Diocta/ISYARA/docs/3d_design/preview_3d_interactive.html

# 📐 ISYARA V2 3D Viewer

Preview langsung file STL cadangan untuk casing perangkat ISYARA (AITC UNAIR 2026).

Assembled Enclosure (Utuh)

💡 Navigasi 3D:

• Klik Kiri + Geser: Putar 360°

• Scroll Mouse: Zoom In / Out

• Klik Kanan + Geser: Panning (Geser Posisi)

Dimensi: 76 × 150 × 22.4 mm
Watertight: Ya (100% Manifold)

📦 Casing Utuh (Assembled) 📱 Sisi User (Back Shell) 📷 Sisi Depan (Front Shell) 🕸️ Wireframe 🔄 Auto Putar
