Diocta/ISYARA/docs/3d_design/preview_back_shell.png

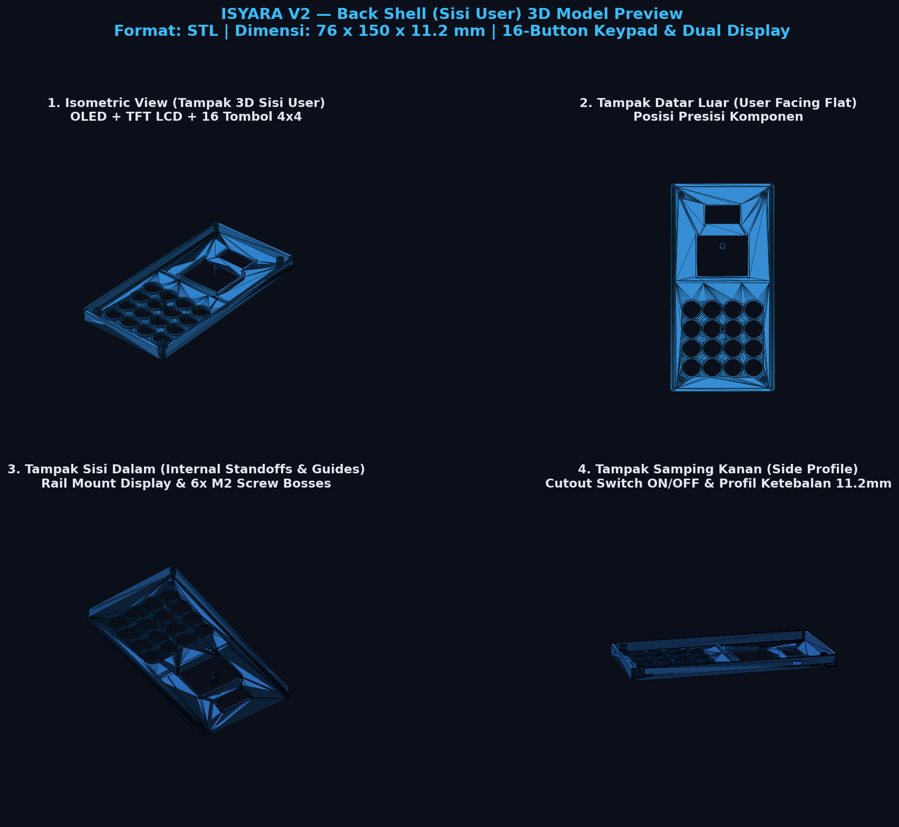
docs/3d_design/preview_back_shell.png
