Diocta/ISYARA/docs/presentation/poster_lipat_dalam.png

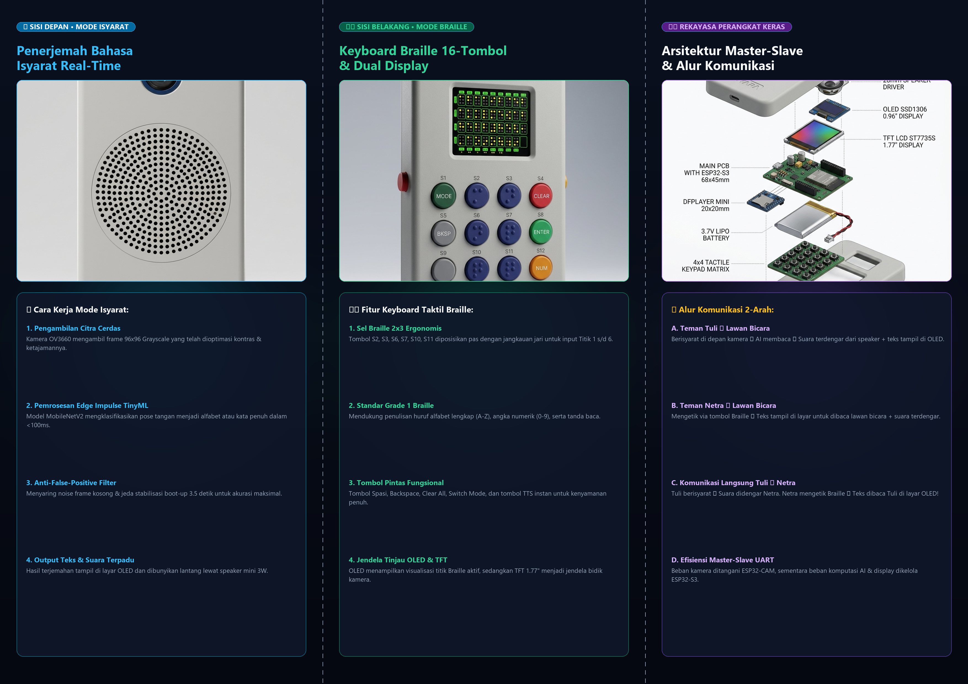
docs/presentation/poster_lipat_dalam.png
