Diocta/ISYARA/docs/presentation/poster_lipat_luar.png

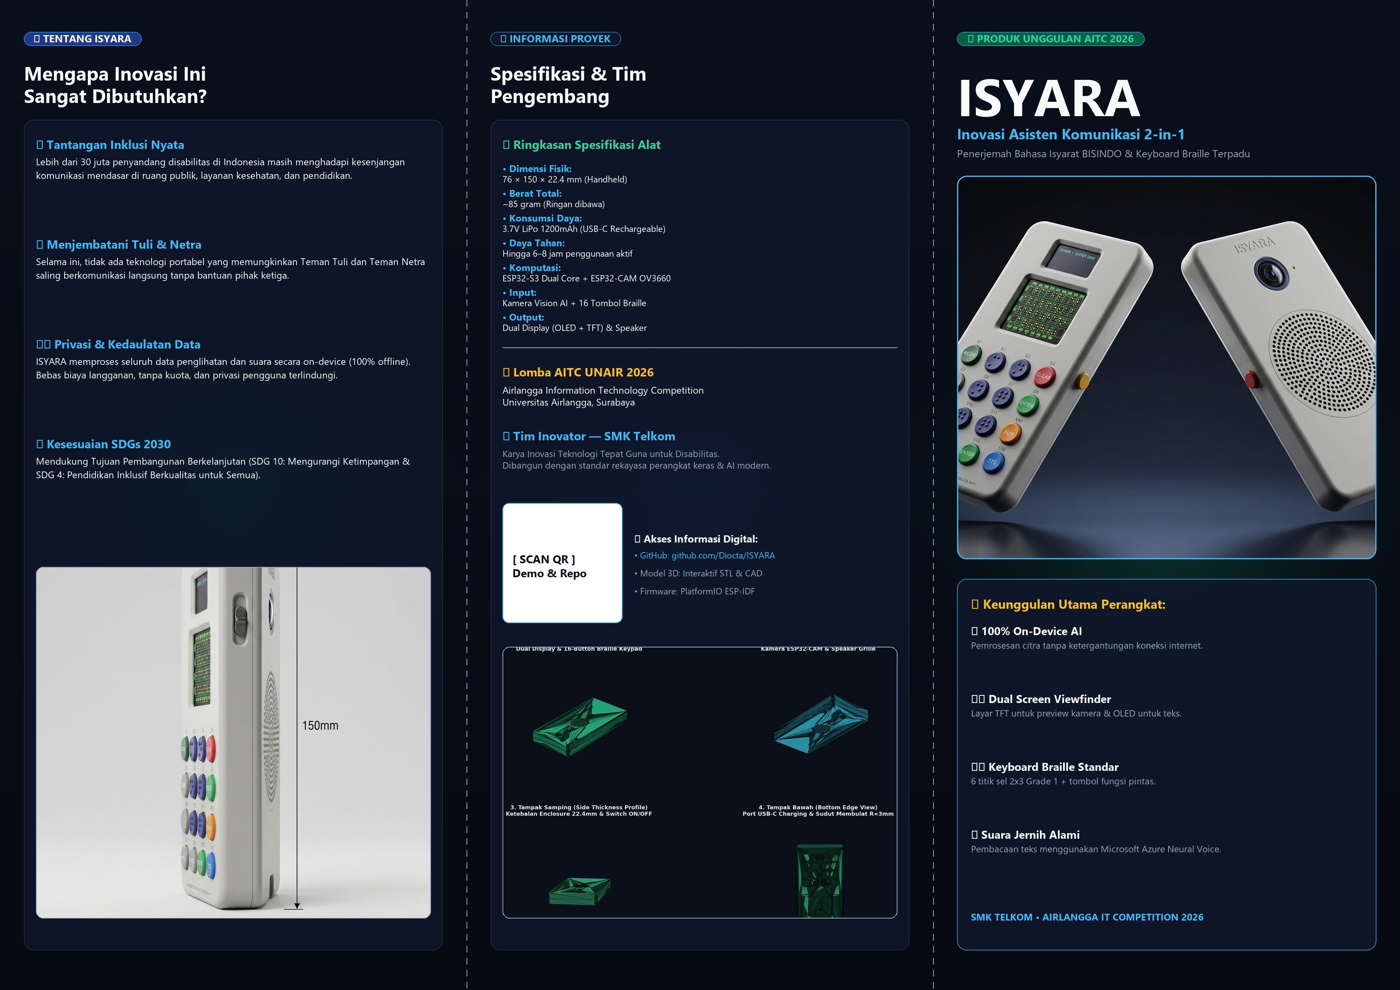
docs/presentation/poster_lipat_luar.png
