Diocta/ISYARA/docs/preview_idle_bw_samples.png

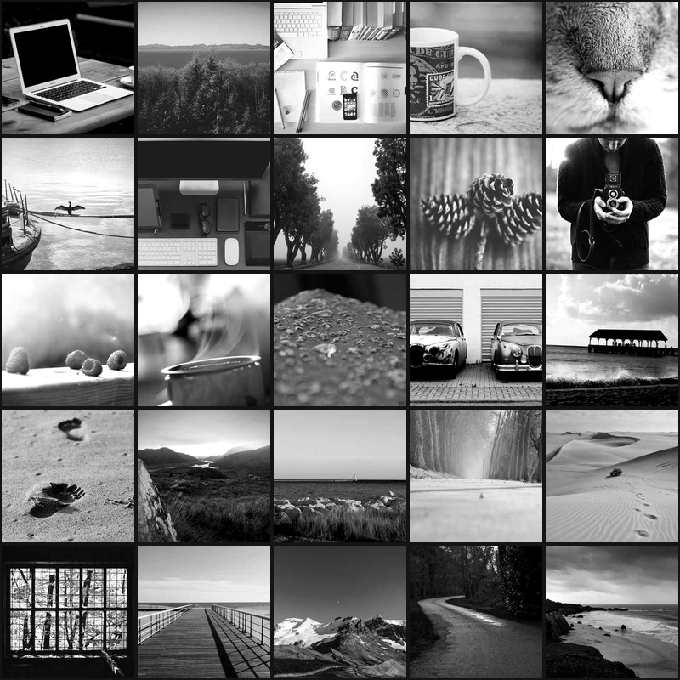
docs/preview_idle_bw_samples.png
