Diocta/ISYARA/docs/3d_design/isyara_assembled_enclosure.stl

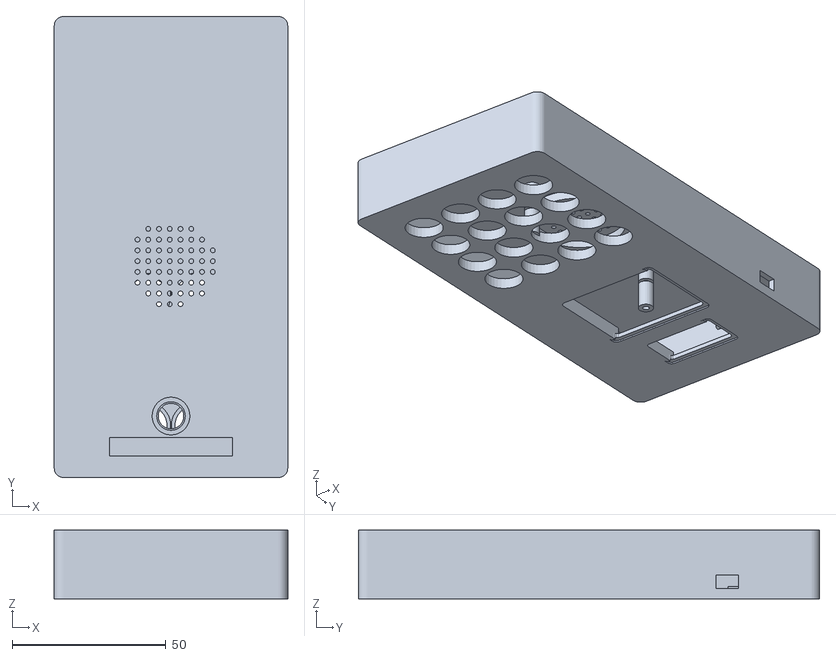
[picture p5: CAD file, 2026-10-30]
docs/3d_design/isyara_assembled_enclosure.stl
76.0 x 150.0 x 22.4
