Diocta/ISYARA/docs/3d_design/isyara_braille_button_cap.stl

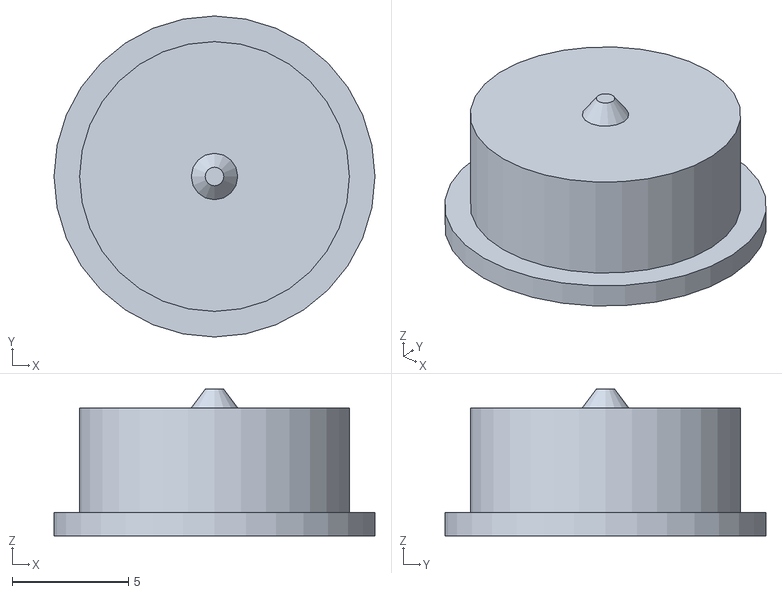
[picture p6: CAD file, 2026-10-30]
docs/3d_design/isyara_braille_button_cap.stl
13.8 x 13.8 x 6.30
