Diocta/ISYARA/docs/3d_design/isyara_back_shell.stl

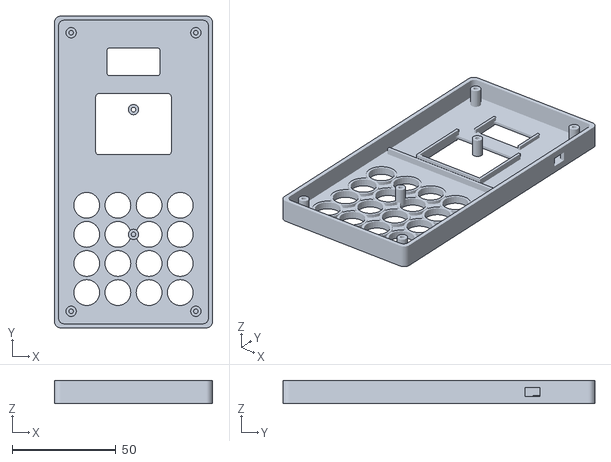
[picture p7: CAD file, 2026-10-30]
docs/3d_design/isyara_back_shell.stl
76.0 x 150.0 x 11.2
