Diocta/ISYARA/(list of files, cad)

Other CAD files:
docs/3d_design/isyara_assembled_enclosure.obj
docs/3d_design/isyara_back_shell.obj
docs/3d_design/isyara_braille_button_cap.obj
docs/3d_design/isyara_front_shell.obj
