Diocta/ISYARA/docs/3d_design/preview_assembled_enclosure.png

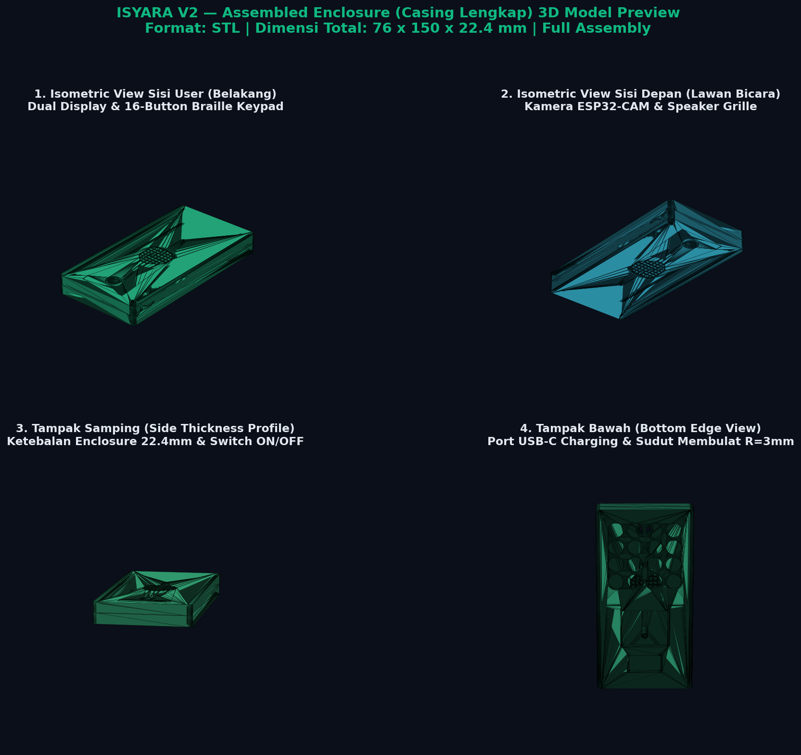
docs/3d_design/preview_assembled_enclosure.png
