Diocta/ISYARA/src/s3/braille_keypad.h

#ifndef BRAILLE_KEYPAD_H
#define BRAILLE_KEYPAD_H

#include <Arduino.h>
#include <Adafruit_GFX.h>
#include <Adafruit_SSD1306.h>
#include <Adafruit_ST7735.h>
#include "audio_manager.h"

// Deklarasi maju softap_add_event (didefinisikan di softap_server.h)
// Stubs akan aktif jika ENABLE_SOFTAP tidak didefinisikan
#ifndef ENABLE_SOFTAP
  inline void softap_add_event(const char*, const char*) {}
#else
  void softap_add_event(const char* source, const char* message);
#endif

// =============================================================================
// ISYARA - Modul Keyboard Braille 4x4 Tactile Matrix (ESP32-S3)
// =============================================================================
// Pemetaan Pinout Modul 4x4 Tactile (Option A Breakout PCB):
// Pin 1 (Top)    = Col 4 -> GPIO 4
// Pin 2          = Col 3 -> GPIO 5
// Pin 3          = Col 2 -> GPIO 6
// Pin 4          = Col 1 -> GPIO 7
// Pin 5          = Row 1 -> GPIO 13
// Pin 6          = Row 2 -> GPIO 16
// Pin 7          = Row 3 -> GPIO 21
// Pin 8 (Bottom) = Row 4 -> GPIO 47
// =============================================================================

// Baris (Rows): Pin 5, 6, 7, 8 pada modul (INPUT_PULLUP)
// Pin 5 = Row 1 -> GPIO 13 (S1, S2, S3, S4)
// Pin 6 = Row 2 -> GPIO 16 (S5, S6, S7, S8)
// Pin 8 = Row 3 -> GPIO 47 (S9, S10, S11, S12)
// Pin 7 = Row 4 -> GPIO 21 (S13, S14, S15, S16)
#define KEYPAD_R1 13
#define KEYPAD_R2 16
#define KEYPAD_R3 47
#define KEYPAD_R4 21

// Kolom (Cols): Pin 4, 3, 2, 1 pada modul (OUTPUT LOW saat di-scan)
// Pin 4 = Col 1 -> GPIO 7  (S1, S5, S9, S13)
// Pin 3 = Col 2 -> GPIO 6  (S2, S6, S10, S14)
// Pin 2 = Col 3 -> GPIO 5  (S3, S7, S11, S15)
// Pin 1 = Col 4 -> GPIO 4  (S4, S8, S12, S16)
#define KEYPAD_C1 7
#define KEYPAD_C2 6
#define KEYPAD_C3 5
#define KEYPAD_C4 4

const uint8_t ROW_PINS[4] = {KEYPAD_R1, KEYPAD_R2, KEYPAD_R3, KEYPAD_R4};
const uint8_t COL_PINS[4] = {KEYPAD_C1, KEYPAD_C2, KEYPAD_C3, KEYPAD_C4};

// Indeks ID Tombol S1 - S16 Sesuai Silkscreen PCB Fisik:
// S1  = (R1, C1) | S2  = (R1, C2) | S3  = (R1, C3) | S4  = (R1, C4)
// S5  = (R2, C1) | S6  = (R2, C2) | S7  = (R2, C3) | S8  = (R2, C4)
// S9  = (R3, C1) | S10 = (R3, C2) | S11 = (R3, C3) | S12 = (R3, C4)
// S13 = (R4, C1) | S14 = (R4, C2) | S15 = (R4, C3) | S16 = (R4, C4)

// State Tombol Matriks (Debounce Independen per Tombol)
static bool key_state[4][4] = {false};
static unsigned long key_debounce_time[4][4] = {0};
const unsigned long DEBOUNCE_MS = 35;

// Indikator Tombol Terakhir untuk Feedback Visual OLED & TFT
static char last_key_badge[16] = "";
static unsigned long last_key_badge_time = 0;
const unsigned long BADGE_DURATION_MS = 1800;

// Buffer Titik Braille (6-dot cell)
// Bit 0: Titik 1 (S2)  | Bit 3: Titik 4 (S3)
// Bit 1: Titik 2 (S6)  | Bit 4: Titik 5 (S7)
// Bit 2: Titik 3 (S10) | Bit 5: Titik 6 (S11)
static uint8_t braille_dots = 0;
static bool number_mode = false;
static unsigned long last_dot_time = 0;
const unsigned long AUTO_COMMIT_MS = 2500; // Nyaman: 2.5 detik untuk mengecek preview titik

// Mode Sistem
enum DeviceMode {
  MODE_AI_BISINDO = 0,
  MODE_BRAILLE = 1
};
extern DeviceMode current_device_mode;
extern String kalimat;
extern bool tft_butuh_update_mode;
extern void perbarui_oled_seketika();

// Fungsi Dekoder Braille (Mask 6-bit -> Karakter ASCII)
char decode_braille_to_char(uint8_t mask, bool is_num) {
  if (mask == 0) return '\0';

  char ch = '\0';
  switch (mask) {
    case 0b000001: ch = 'A'; break; // Titik 1
    case 0b000011: ch = 'B'; break; // Titik 1, 2
    case 0b001001: ch = 'C'; break; // Titik 1, 4
    case 0b011001: ch = 'D'; break; // Titik 1, 4, 5
    case 0b010001: ch = 'E'; break; // Titik 1, 5
    case 0b001011: ch = 'F'; break; // Titik 1, 2, 4
    case 0b011011: ch = 'G'; break; // Titik 1, 2, 4, 5
    case 0b010011: ch = 'H'; break; // Titik 1, 2, 5
    case 0b001010: ch = 'I'; break; // Titik 2, 4
    case 0b011010: ch = 'J'; break; // Titik 2, 4, 5
    case 0b000101: ch = 'K'; break; // Titik 1, 3
    case 0b000111: ch = 'L'; break; // Titik 1, 2, 3
    case 0b001101: ch = 'M'; break; // Titik 1, 3, 4
    case 0b011101: ch = 'N'; break; // Titik 1, 3, 4, 5
    case 0b010101: ch = 'O'; break; // Titik 1, 3, 5
    case 0b001111: ch = 'P'; break; // Titik 1, 2, 3, 4
    case 0b011111: ch = 'Q'; break; // Titik 1, 2, 3, 4, 5
    case 0b010111: ch = 'R'; break; // Titik 1, 2, 3, 5
    case 0b001110: ch = 'S'; break; // Titik 2, 3, 4
    case 0b011110: ch = 'T'; break; // Titik 2, 3, 4, 5
    case 0b100101: ch = 'U'; break; // Titik 1, 3, 6
    case 0b100111: ch = 'V'; break; // Titik 1, 2, 3, 6
    case 0b111010: ch = 'W'; break; // Titik 2, 4, 5, 6
    case 0b101101: ch = 'X'; break; // Titik 1, 3, 4, 6
    case 0b111101: ch = 'Y'; break; // Titik 1, 3, 4, 5, 6
    case 0b110101: ch = 'Z'; break; // Titik 1, 3, 5, 6
    
    // Tanda Baca
    case 0b000010: ch = ','; break;
    case 0b110010: ch = '.'; break;
    case 0b100110: ch = '?'; break;
    case 0b010110: ch = '!'; break;
    case 0b100100: ch = '-'; break;
    default: ch = '?'; break;
  }

  if (is_num && ch >= 'A' && ch <= 'J') {
    if (ch == 'J') return '0';
    return (char)('1' + (ch - 'A'));
  }

  return ch;
}

// Inisialisasi Pin Keypad 4x4
void braille_keypad_init() {
  for (int r = 0; r < 4; r++) {
    pinMode(ROW_PINS[r], INPUT_PULLUP);
  }
  for (int c = 0; c < 4; c++) {
    pinMode(COL_PINS[c], INPUT);
  }
  Serial.println("[BRAILLE] Keypad 4x4 Diinisialisasi (Rows: 13,16,47,21 | Cols: 7,6,5,4)");
  Serial.println("==================================================");
  Serial.println("  ISYARA - Layout Fisik Keyboard Braille 4x4:");
  Serial.println("  [S1:Mode]   [S2:Dot1]   [S3:Dot4]   [S4:Clear]");
  Serial.println("  [S5:Bksp]   [S6:Dot2]   [S7:Dot5]   [S8:Enter]");
  Serial.println("  [S9:Space]  [S10:Dot3]  [S11:Dot6]  [S12:Num]");
  Serial.println("  [S13:Bksp]  [S14:Space] [S15:Enter] [S16:TTS]");
  Serial.println("==================================================");
}

// Fungsi Commit Karakter Braille ke Kalimat
void commit_braille_char() {
  if (braille_dots != 0) {
    char c = decode_braille_to_char(braille_dots, number_mode);
    if (c != '\0' && c != '?') {
      kalimat += c;
      Serial.printf("[BRAILLE] Huruf Dikunci: '%c' (Mask: 0x%02X) -> Kalimat: %s\n", c, braille_dots, kalimat.c_str());
      audio.playChar(c);
      // Catat event ke SoftAP Dashboard log
      char ch_str[3] = {c, '\0', '\0'};
      softap_add_event("Keyboard Braille", ch_str);
    } else {
      Serial.printf("[BRAILLE] Pola Titik Tidak Dikenal (Mask: 0x%02X)\n", braille_dots);
    }
    braille_dots = 0;
  }
}

// Handler Aksi Setiap Tombol S1 - S16
void handle_key_action(int key_num) {
  Serial.printf("[KEYPAD] Tombol S%d Ditekan! ", key_num);

  // Hanya tombol titik Braille (S2, S3, S6, S7, S10, S11) yang memicu auto-switch ke Mode Braille.
  // Tombol fungsi utilitas (Spasi, Backspace, Clear, TTS) tetap bekerja pada mode aktif saat ini.
  bool is_braille_dot = (key_num == 2 || key_num == 3 || key_num == 6 || 
                         key_num == 7 || key_num == 10 || key_num == 11);

  if (is_braille_dot && current_device_mode != MODE_BRAILLE) {
    current_device_mode = MODE_BRAILLE;
    tft_butuh_update_mode = true;
    Serial.print("[AUTO SWITCH KE BRAILLE MODE] ");
    audio.playModeChange(true);
  }

  switch (key_num) {
    // Tombol S1: Ganti Mode Sistem (BISINDO AI <-> BRAILLE KEYBOARD)
    case 1:
      snprintf(last_key_badge, sizeof(last_key_badge), "S1:MODE");
      last_key_badge_time = millis();
      tft_butuh_update_mode = true;
      if (current_device_mode == MODE_AI_BISINDO) {
        current_device_mode = MODE_BRAILLE;
        Serial.println("-> MODE SWITCH: BRAILLE KEYBOARD AKTIF");
        audio.playModeChange(true);
      } else {
        current_device_mode = MODE_AI_BISINDO;
        Serial.println("-> MODE SWITCH: AI BISINDO AKTIF");
        audio.playModeChange(false);
      }
      break;

    // Titik-titik Braille (2x3 Cell Grid di S2, S3, S6, S7, S10, S11)
    case 2:  // S2: Titik 1 (Kiri Atas)
      snprintf(last_key_badge, sizeof(last_key_badge), "S2:DOT 1");
      last_key_badge_time = millis();
      braille_dots ^= (1 << 0);
      last_dot_time = millis();
      Serial.println("-> Titik 1 (Kiri Atas) Ditekan");
      break;

    case 3:  // S3: Titik 4 (Kanan Atas)
      snprintf(last_key_badge, sizeof(last_key_badge), "S3:DOT 4");
      last_key_badge_time = millis();
      braille_dots ^= (1 << 3);
      last_dot_time = millis();
      Serial.println("-> Titik 4 (Kanan Atas) Ditekan");
      break;

    case 4:  // S4: Clear All (Hapus Seluruh Kalimat)
      snprintf(last_key_badge, sizeof(last_key_badge), "S4:CLEAR");
      last_key_badge_time = millis();
      kalimat = "";
      braille_dots = 0;
      Serial.println("-> HAPUS SELURUH TEKS (Clear All)");
      audio.playClear();
      perbarui_oled_seketika();
      break;

    case 5:  // S5: Backspace (Hapus 1 Karakter Terakhir)
    case 13: // S13: Alternatif Backspace (Pojok Kiri Bawah)
      snprintf(last_key_badge, sizeof(last_key_badge), (key_num == 5) ? "S5:BKSP" : "S13:BKSP");
      last_key_badge_time = millis();
      if (current_device_mode == MODE_BRAILLE && braille_dots != 0) {
        braille_dots = 0;
        Serial.println("-> Batalkan Titik Aktif");
      } else if (kalimat.length() > 0) {
        kalimat.remove(kalimat.length() - 1);
        Serial.printf("-> Backspace: %s\n", kalimat.c_str());
        audio.playBackspace();
        perbarui_oled_seketika();
      }
      break;

    case 6:  // S6: Titik 2 (Kiri Tengah)
      snprintf(last_key_badge, sizeof(last_key_badge), "S6:DOT 2");
      last_key_badge_time = millis();
      braille_dots ^= (1 << 1);
      last_dot_time = millis();
      Serial.println("-> Titik 2 (Kiri Tengah) Ditekan");
      break;

    case 7:  // S7: Titik 5 (Kanan Tengah)
      snprintf(last_key_badge, sizeof(last_key_badge), "S7:DOT 5");
      last_key_badge_time = millis();
      braille_dots ^= (1 << 4);
      last_dot_time = millis();
      Serial.println("-> Titik 5 (Kanan Tengah) Ditekan");
      break;

    case 8:  // S8: Enter / Kunci Huruf Sekarang
    case 15: // S15: Alternatif Enter (Baris Bawah)
      snprintf(last_key_badge, sizeof(last_key_badge), (key_num == 8) ? "S8:ENTER" : "S15:ENTER");
      last_key_badge_time = millis();
      commit_braille_char();
      Serial.println("-> Enter / Commit Huruf");
      break;

    case 9:  // S9: Spasi
    case 14: // S14: Alternatif Spasi (Baris Bawah)
      snprintf(last_key_badge, sizeof(last_key_badge), (key_num == 9) ? "S9:SPASI" : "S14:SPASI");
      last_key_badge_time = millis();
      if (current_device_mode == MODE_BRAILLE) {
        commit_braille_char();
      }
      kalimat += " ";
      Serial.printf("-> Tambah Spasi -> Kalimat: '%s'\n", kalimat.c_str());
      audio.playChar(' ');
      perbarui_oled_seketika();
      break;

    case 10: // S10: Titik 3 (Kiri Bawah)
      snprintf(last_key_badge, sizeof(last_key_badge), "S10:DOT 3");
      last_key_badge_time = millis();
      braille_dots ^= (1 << 2);
      last_dot_time = millis();
      Serial.println("-> Titik 3 (Kiri Bawah) Ditekan");
      break;

    case 11: // S11: Titik 6 (Kanan Bawah)
      snprintf(last_key_badge, sizeof(last_key_badge), "S11:DOT 6");
      last_key_badge_time = millis();
      braille_dots ^= (1 << 5);
      last_dot_time = millis();
      Serial.println("-> Titik 6 (Kanan Bawah) Ditekan");
      break;

    case 12: // S12: Mode Angka / Huruf
      number_mode = !number_mode;
      snprintf(last_key_badge, sizeof(last_key_badge), number_mode ? "S12:[NUM]" : "S12:[A-Z]");
      last_key_badge_time = millis();
      Serial.printf("-> Mode Angka: %s\n", number_mode ? "AKTIF" : "NONAKTIF");
      break;

    case 16: // S16: Tombol TTS / Suara (Pojok Kanan Bawah)
      snprintf(last_key_badge, sizeof(last_key_badge), "S16:TTS");
      last_key_badge_time = millis();
      Serial.printf("-> SUARA / BACA TEKS: '%s'\n", kalimat.c_str());
      audio.readSentence(kalimat);
      break;

    default:
      Serial.println();
      break;
  }
}

// Fungsi Update Matrix Scanner (Debounce Independen per Tombol)
void braille_keypad_update() {
  unsigned long now = millis();

  // Scan Matriks 4x4
  for (int c = 0; c < 4; c++) {
    pinMode(COL_PINS[c], OUTPUT);
    digitalWrite(COL_PINS[c], LOW);
    delayMicroseconds(45); // Waktu stabilisasi sinyal

    for (int r = 0; r < 4; r++) {
      bool is_pressed = (digitalRead(ROW_PINS[r]) == LOW);

      if (is_pressed != key_state[r][c]) {
        if (now - key_debounce_time[r][c] > DEBOUNCE_MS) {
          key_debounce_time[r][c] = now;
          key_state[r][c] = is_pressed;

          if (is_pressed) {
            int key_num = (r * 4) + c + 1; // S1 sampai S16
            Serial.printf("[KEYPAD] Tombol S%d Terdeteksi (Row%d:GPIO%d, Col%d:GPIO%d)\n",
                          key_num, r + 1, ROW_PINS[r], c + 1, COL_PINS[c]);
            handle_key_action(key_num);
          }
        }
      }
    }

    pinMode(COL_PINS[c], INPUT); // Lepas kembali ke High-Z
  }

  // Auto-commit huruf braille setelah tidak ada tombol ditekan selama AUTO_COMMIT_MS
  if (braille_dots != 0 && (now - last_dot_time > AUTO_COMMIT_MS)) {
    commit_braille_char();
  }
}

// =============================================================================
// 1. MONITOR UTAMA BRAILLE PADA LAYAR LCD TFT 1.77" (ST7735S 160x128 SPI)
// =============================================================================
// Menampilkan Grid 6 Titik Braille Berwarna, Karakter Preview Besar, Badge Tombol, & Kalimat
void render_braille_tft(Adafruit_ST7735 &tft, bool force_redraw) {
  static uint8_t prev_dots = 255;
  static bool prev_num_mode = false;
  static String prev_kalimat = "___INIT___";
  static char prev_badge[16] = "___INIT___";

  bool badge_active = (millis() - last_key_badge_time < BADGE_DURATION_MS && last_key_badge[0] != '\0');

  if (force_redraw) {
    tft.fillScreen(ST77XX_BLACK);

    // Header Bar
    tft.fillRect(0, 0, 160, 16, 0x0012); // Latar belakang biru tua
    tft.setTextSize(1);
    tft.setTextColor(ST77XX_CYAN, 0x0012);
    tft.setCursor(4, 4);
    tft.print("ISYARA BRAILLE");

    // Garis Pemisah Header
    tft.drawFastHLine(0, 16, 160, ST77XX_CYAN);

    // Garis Pemisah Vertikal Tengah
    tft.drawFastVLine(70, 17, 76, 0x31A6);

    // Garis Pemisah Bawah (Area Teks)
    tft.drawFastHLine(0, 93, 160, ST77XX_CYAN);
    tft.setTextSize(1);
    tft.setTextColor(ST77XX_YELLOW, ST77XX_BLACK);
    tft.setCursor(4, 96);
    tft.print("TEKS:");

    prev_dots = 255;
    prev_kalimat = "___FORCE___";
    prev_badge[0] = '\0';
  }

  // A. Mode Badge di Header [A-Z] atau [NUM]
  if (prev_num_mode != number_mode || force_redraw) {
    prev_num_mode = number_mode;
    tft.setTextSize(1);
    tft.setCursor(120, 4);
    if (number_mode) {
      tft.setTextColor(ST77XX_ORANGE, 0x0012);
      tft.print("[NUM]");
    } else {
      tft.setTextColor(ST77XX_GREEN, 0x0012);
      tft.print("[A-Z]");
    }
  }

  // B. Visualisasi 6 Titik Braille (Grid 2x3 di sisi kiri x:4 sampai x:68)
  int tft_dot_coords[6][2] = {
    {20, 30}, // Titik 1 (S2)
    {20, 52}, // Titik 2 (S6)
    {20, 74}, // Titik 3 (S10)
    {50, 30}, // Titik 4 (S3)
    {50, 52}, // Titik 5 (S7)
    {50, 74}  // Titik 6 (S11)
  };

  if (prev_dots != braille_dots || force_redraw) {
    for (int i = 0; i < 6; i++) {
      int cx = tft_dot_coords[i][0];
      int cy = tft_dot_coords[i][1];
      bool is_on = (braille_dots & (1 << i));
      bool was_on = (prev_dots & (1 << i));

      if (is_on != was_on || force_redraw) {
        if (is_on) {
          tft.fillCircle(cx, cy, 7, ST77XX_YELLOW); // Aktif: Kuning Cerah
          tft.drawCircle(cx, cy, 7, ST77XX_WHITE);
        } else {
          tft.fillCircle(cx, cy, 7, 0x18C3);        // Kosong: Abu-abu redup
          tft.drawCircle(cx, cy, 7, 0x7BEF);
        }
      }
    }
    prev_dots = braille_dots;

    // C. Karakter Preview Besar (Ukuran 4 di Sisi Kanan)
    char preview_ch = decode_braille_to_char(braille_dots, number_mode);
    tft.setTextSize(1);
    tft.setTextColor(ST77XX_CYAN, ST77XX_BLACK);
    tft.setCursor(80, 22);
    tft.print("PREVIEW:");

    tft.fillRect(84, 34, 48, 32, ST77XX_BLACK);
    tft.setCursor(94, 36);
    if (braille_dots != 0) {
      tft.setTextSize(4);
      tft.setTextColor(ST77XX_WHITE, ST77XX_BLACK);
      if (preview_ch != '\0' && preview_ch != '?') {
        tft.print(preview_ch);
      } else {
        tft.setTextColor(ST77XX_RED, ST77XX_BLACK);
        tft.print("?");
      }
    } else {
      tft.setTextSize(2);
      tft.setTextColor(0x52AA, ST77XX_BLACK);
      tft.setCursor(96, 42);
      tft.print("[-]");
    }
  }

  // D. Badge Tombol Terakhir
  if (strcmp(prev_badge, last_key_badge) != 0 || force_redraw) {
    strncpy(prev_badge, last_key_badge, sizeof(prev_badge));
    tft.fillRect(74, 70, 84, 18, ST77XX_BLACK);
    if (badge_active) {
      tft.fillRoundRect(74, 70, 84, 18, 3, 0x001F);
      tft.drawRoundRect(74, 70, 84, 18, 3, ST77XX_CYAN);
      tft.setTextSize(1);
      tft.setTextColor(ST77XX_YELLOW, 0x001F);
      tft.setCursor(78, 75);
      tft.print(last_key_badge);
    } else {
      tft.setTextSize(1);
      tft.setTextColor(0x52AA, ST77XX_BLACK);
      tft.setCursor(80, 75);
      tft.print("Siap Ketik");
    }
  } else if (!badge_active && prev_badge[0] != '\0') {
    prev_badge[0] = '\0';
    tft.fillRect(74, 70, 84, 18, ST77XX_BLACK);
    tft.setTextSize(1);
    tft.setTextColor(0x52AA, ST77XX_BLACK);
    tft.setCursor(80, 75);
    tft.print("Siap Ketik");
  }

  // E. Baris Teks Kalimat Hasil Ketikan
  if (prev_kalimat != kalimat || force_redraw) {
    prev_kalimat = kalimat;
    tft.fillRect(0, 107, 160, 20, ST77XX_BLACK);
    tft.setCursor(4, 108);
    tft.setTextSize(1);
    if (kalimat.length() == 0) {
      tft.setTextColor(0x7BEF, ST77XX_BLACK);
      tft.print("(Mulai ketik via keypad)");
    } else {
      String teks_scroll = (kalimat.length() > 22)
        ? (".." + kalimat.substring(kalimat.length() - 20))
        : kalimat;
      tft.setTextColor(ST77XX_GREEN, ST77XX_BLACK);
      tft.print(teks_scroll);
    }
  }
}

// =============================================================================
// 2. DASHBOARD & TELEMETRY SISTEM PADA LAYAR OLED KECIL 0.96" (SSD1306 128x64 I2C)
// =============================================================================
// Menampilkan Status Hardware, Kamera Sleep/Dingin, Statistik Kata, & Panduan Tombol
void render_braille_oled_dashboard(Adafruit_SSD1306 &display) {
  display.clearDisplay();
  display.setTextWrap(false); // Cegah teks panjang membungkus (wrapping) ke baris bawahnya

  // 1. Header Bar
  display.setTextSize(1);
  display.setTextColor(WHITE);
  display.setCursor(0, 0);
  display.print("ISYARA - SYSTEM DASH");
  display.drawFastHLine(0, 9, 128, WHITE);

  // 2. Status ESP32-CAM (Kamera dimatikan agar hemat daya dan dingin)
  display.setCursor(0, 13);
  display.print("Kamera : SLEEP [OFF]");

  // 3. Statistik Pengetikan
  display.setCursor(0, 24);
  int kata_count = 0;
  bool in_word = false;
  for (unsigned int i = 0; i < kalimat.length(); i++) {
    char c = kalimat.charAt(i);
    if (c != ' ' && c != '\t' && c != '\n' && c != '\r') {
      if (!in_word) { kata_count++; in_word = true; }
    } else {
      in_word = false;
    }
  }
  display.printf("Teks   : %d Kata (%dH)", kata_count, (int)kalimat.length());

  // 4. Status Modul Suara / DFPlayer Mini (muat dalam 21 karakter lebar layar)
  display.setCursor(0, 35);
  display.print("Audio  : SIAP (Vol 24)");

  // 5. Divider Bawah & Petunjuk Cepat Tombol
  display.drawFastHLine(0, 47, 128, WHITE);
  display.setCursor(0, 52);
  display.print("[S1]Kamera  [S16]TTS");

  display.display();
}

// Kompatibilitas mundur
void render_braille_oled(Adafruit_SSD1306 &display) {
  render_braille_oled_dashboard(display);
}

#endif // BRAILLE_KEYPAD_H
