Diocta/ISYARA/(commit log)

2026-10-15 update esp32cam AI dataset A-I + oled
2026-10-15 feat: Braille Keyboard 4x4 matrix integration (feature/braille-keyboard)
    - Add src/s3/braille_keypad.h: full 4x4 matrix scanner (GPIO 4-7 rows,
    GPIO 10-13 cols), Grade 1 Braille decoder (A-Z, 0-9, punctuation),
    OLED visualizer with 6-dot preview, auto-commit 850ms, debounce 25ms
    - Merge rekan updates into src/s3/main.cpp:
    * PSRAM-aware ei_calloc() for TFLite Micro arena (64KB+ -> PSRAM)
    * UART baud 460800, header timeout 1000ms, frame timeout 1000ms
    * Sliding header parser (byte-by-byte 0xAA 0x55)
    * gambar_status_kunci(): lock/clock icon on OLED
    * menunggu_lepas_tangan anti-repeat (600ms release window)
    * UART diagnostics on OLED and Serial Monitor
    * AI ERR state shown on O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
2026-10-17 fix: non-blocking audio init and responsive keypad scanning during camera standby
    [audio_manager.h, main.cpp]
2026-10-17 feat: universal all-pairs 8-pin keypad scanner with real-time OLED pin feedback
2026-10-17 fix: calibrated 4x4 keypad matrix decoder, eliminate multi-core OLED corruption, and add TFT Braille banner
    [braille_keypad.h, main.cpp]
2026-10-17 fix: swap Row 3 & 4 keypad mapping, add per-key debounce, and visual on-screen button badges
    [braille_keypad.h]
2026-10-17 docs: update PROJECT_JOURNAL.md with keypad matrix calibration and UX improvements
2026-10-17 feat: TFT Braille visualizer, OLED telemetry dashboard, and camera sleep thermal management
2026-10-17 fix(tft-cam): resolve tft white screen on boot, restore ov3660 camera stability and freertos cpu throttling
    [braille_keypad.h, main.cpp]
2026-10-17 fix(tft): decouple CS pin from hardware SS lock, use standard SPI with 16MHz clock and boot flash test
    [main.cpp]
2026-10-22 fix(ai): prevent false-positive 'E' detection on boot and empty camera frames
    - Discard first 3 camera frames on boot for AE/AWB sensor stabilization
    - Add 3.5s boot warmup delay to ignore transient frames and reset buffer
    - Add frame dynamic range and contrast check (reject empty/blank frames)
    - Raise confidence threshold from 55% to 70% for stable inference
    - Add word-level recognition formatting and audio playback support
    [audio_manager.h, main.cpp, word_dictionary.h]
2026-10-24 fix(oled): prevent text wrapping and collision on braille OLED dashboard
    [braille_keypad.h, main.cpp]
2026-10-30 feat: tambah SoftAP Web Dashboard (softap_server.h) + integrasi firmware
    - Tambah modul softap_server.h (WebServer port 80, SoftAP SSID ISYARA-MED-01)
    - Dashboard HTML dark-medical embedded sebagai PROGMEM string
    - REST API: GET /api/status, GET /api/log, POST /api/message
    - Ring buffer 10 event terbaru (AI BISINDO + Keyboard Braille)
    - Pesan perawat tampil real-time di TFT pasien via POST /api/message
    - Integrasi main.cpp: softap_begin() di setup(), softap_handle() di loop()
    - Integrasi braille_keypad.h: softap_add_event() saat huruf dikunci
    - Feature toggle via -DENABLE_SOFTAP di platformio.ini (build_flags)
    - Update .gitignore: exclude docx/pptx/pdf/dataset besar
    - Tambah docs/ (3D design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
    [isyara_assembled_enclosure.obj, isyara_assembled_enclosure.stl, isyara_back_shell.obj, isyara_back_shell.scad, isyara_back_shell.stl, isyara_braille_button_cap.obj, isyara_braille_button_cap.stl, isyara_front_shell.obj]
